DylanCaen/Linefollower/readme.md

# LineFollower
<br />
<br />
[line follower](https://user-images.githubusercontent.com/114856811/209238301-1bc431f7-9a41-4f4b-89cb-30bd2896c6eb.jpg)
<br />
<br />
  
## specifications
<br />
microcontroller: Atmega32U4 (Arduino pro micro)
<br />
motors: Micro metal gear motor 50:1 6V 650rpm 
<br />
h-bridge: DRV8833
<br />
sensors: QTR-8A
<br />
batteries: 2x li-ion 3,7V, 2600mAh
<br />
wireless communication: HC-05 (bluethooth)
<br />
distance sensor - motors: 12cm
<br />
weight: 300gr
<br />
speed: 0,565m/s
<br />
