DylanCaen/Linefollower/code/proof of concepts/readme.md

# Proof of Concepts

Een proof of concept is een combinatie van minimale hard- en software om eenvoudig aan te tonen dat iets werkt.  
Proof of concepts kunnen enerzijds als eerste poging dienen om een bepaald onderdeel van het project werkend te krijgen. Anderzijds kunnen ze tijdens het debuggen van het finale project dienen als test om eventuele hardware problemen te elimineren bij onduidelijke problemen.
<br />  
<br />
Een proof of concept bestaat uit
* een elektronisch schema (indien van toepassing)
* minimale code om de voorop gestelde zaken te demonstreren
* minimale uitleg / aandachtspunten
<br />
De elektronische schakelingen van de proof of concepts komen bij voorkeur overeen met deze van de uiteindelijke linefollower, zodat de code zonder aanpassingen op het finale project kan draaien.
