DylanCaen/Linefollower/bill of materials/readme.md

## bill of materials
<br />

|volgnummer|naam|omschrijving|nieuw/recup|kostprijs/stuk (€)|aantal|subtotaal|
|---|----|---|---|---|---|---|
| 1|Li-ion batterij|3,7V; 2600mAh|nieuw|2,95|2|5,90|
| 2|Li-ion batterij lader||nieuw|7,99|1|7,99| 
| 3|Li-ion batterij houder||nieuw|1,39|1|1,39|
| 4|Micro metal Gear Motor|50:1; 6V; 650rpm|nieuw|6,95|2|13,90|
| 5|DRV8833|H-brug (2,7V-10,8V)|nieuw|5,75|1|5,75|
| 6|QTR-8A|Sensor (3,3V-5V)|nieuw|12,28|1|12,28|
| 7|HC-05|Bleuthooth-module|recup| | | |
| 8|Arduino Pro Micro|Atmega 32U|recup| | | |
| 9|Printplaat|grondplaat|recup| | | |
| 10|Drukknop|Start/Stop drukknop|recup| | | |
| 11|Schakelaar|Power On/Off|recup| | | |
| 12|Led|On/Off Led|recup| | | |
| 13|Wielen||nieuw|4,88|1|4,88|
| 14|Micro metal Gear Motor bracket|Bevestiging voor de motoren|nieuw|3,64|1|3,64|
