DylanCaen/Linefollower/code/proof of concepts/sensor/Schema QTR-8A sensor.pdf

A | A

1

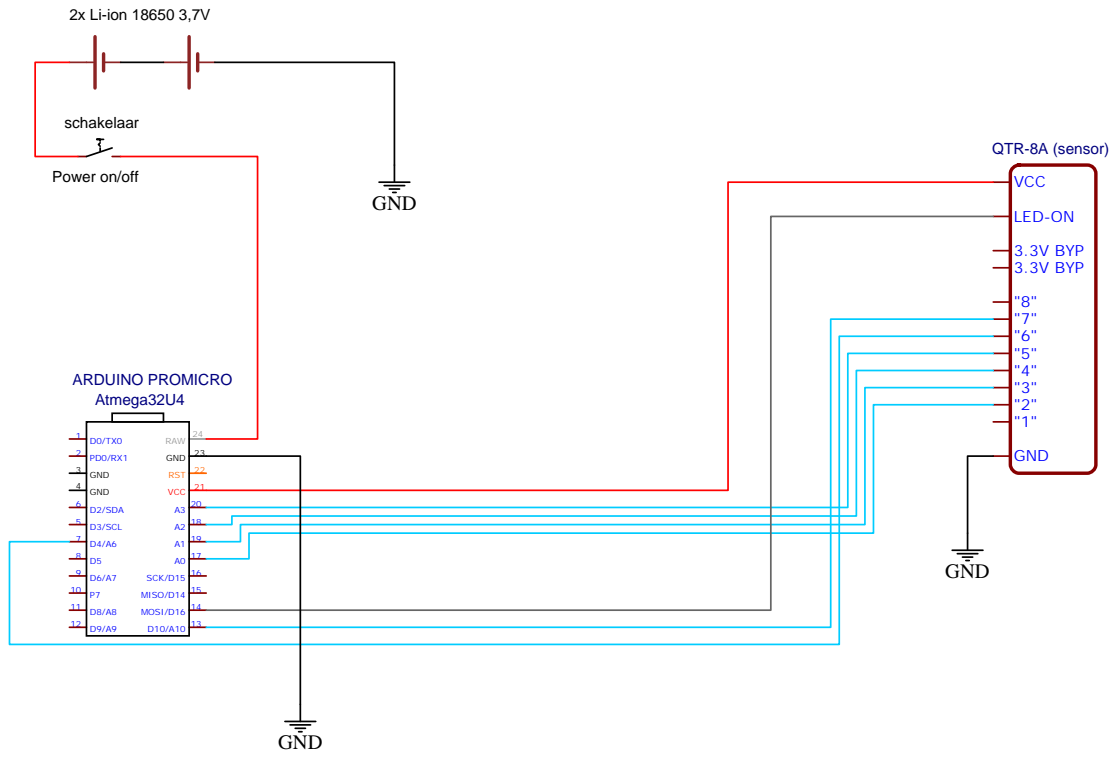
[picture p7: page 1]

TITLE: Elektrisch schema QTR-8A sensor
