DylanCaen/Linefollower/code/proof of concepts/interrupt/Schema drukknop (interrupt).pdf

A | A

1

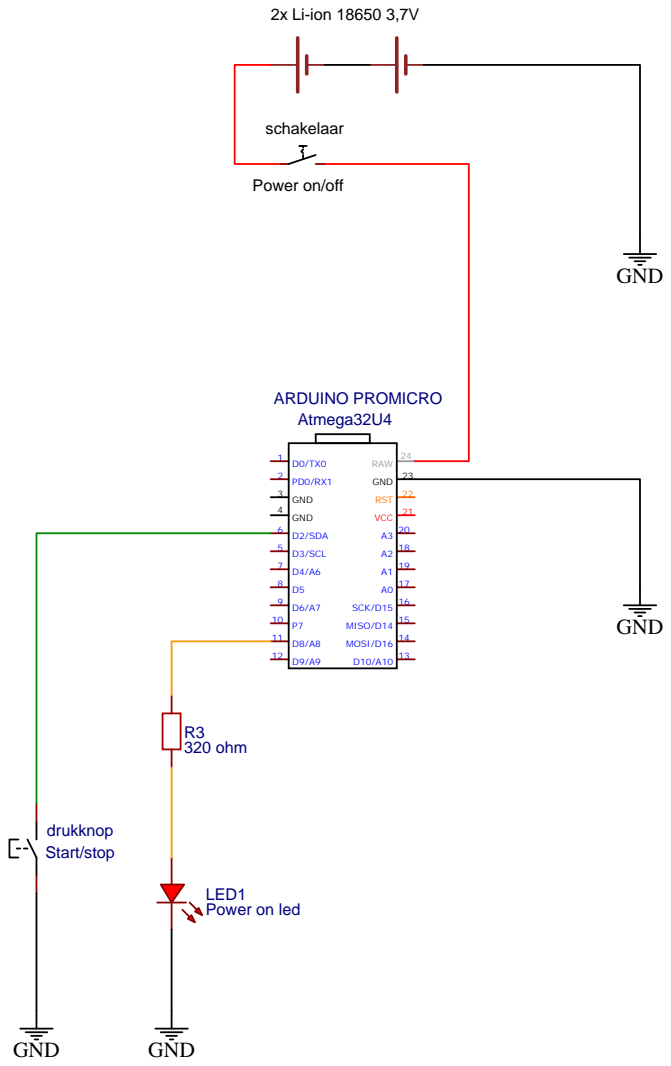
[picture p8: page 1]

TITLE: Elektrisch schema Start/Stop drukknopmet Power on led
