DylanCaen/Linefollower/code/proof of concepts/hbridge/Schema Hbrige + motoren.pdf

A | A

1

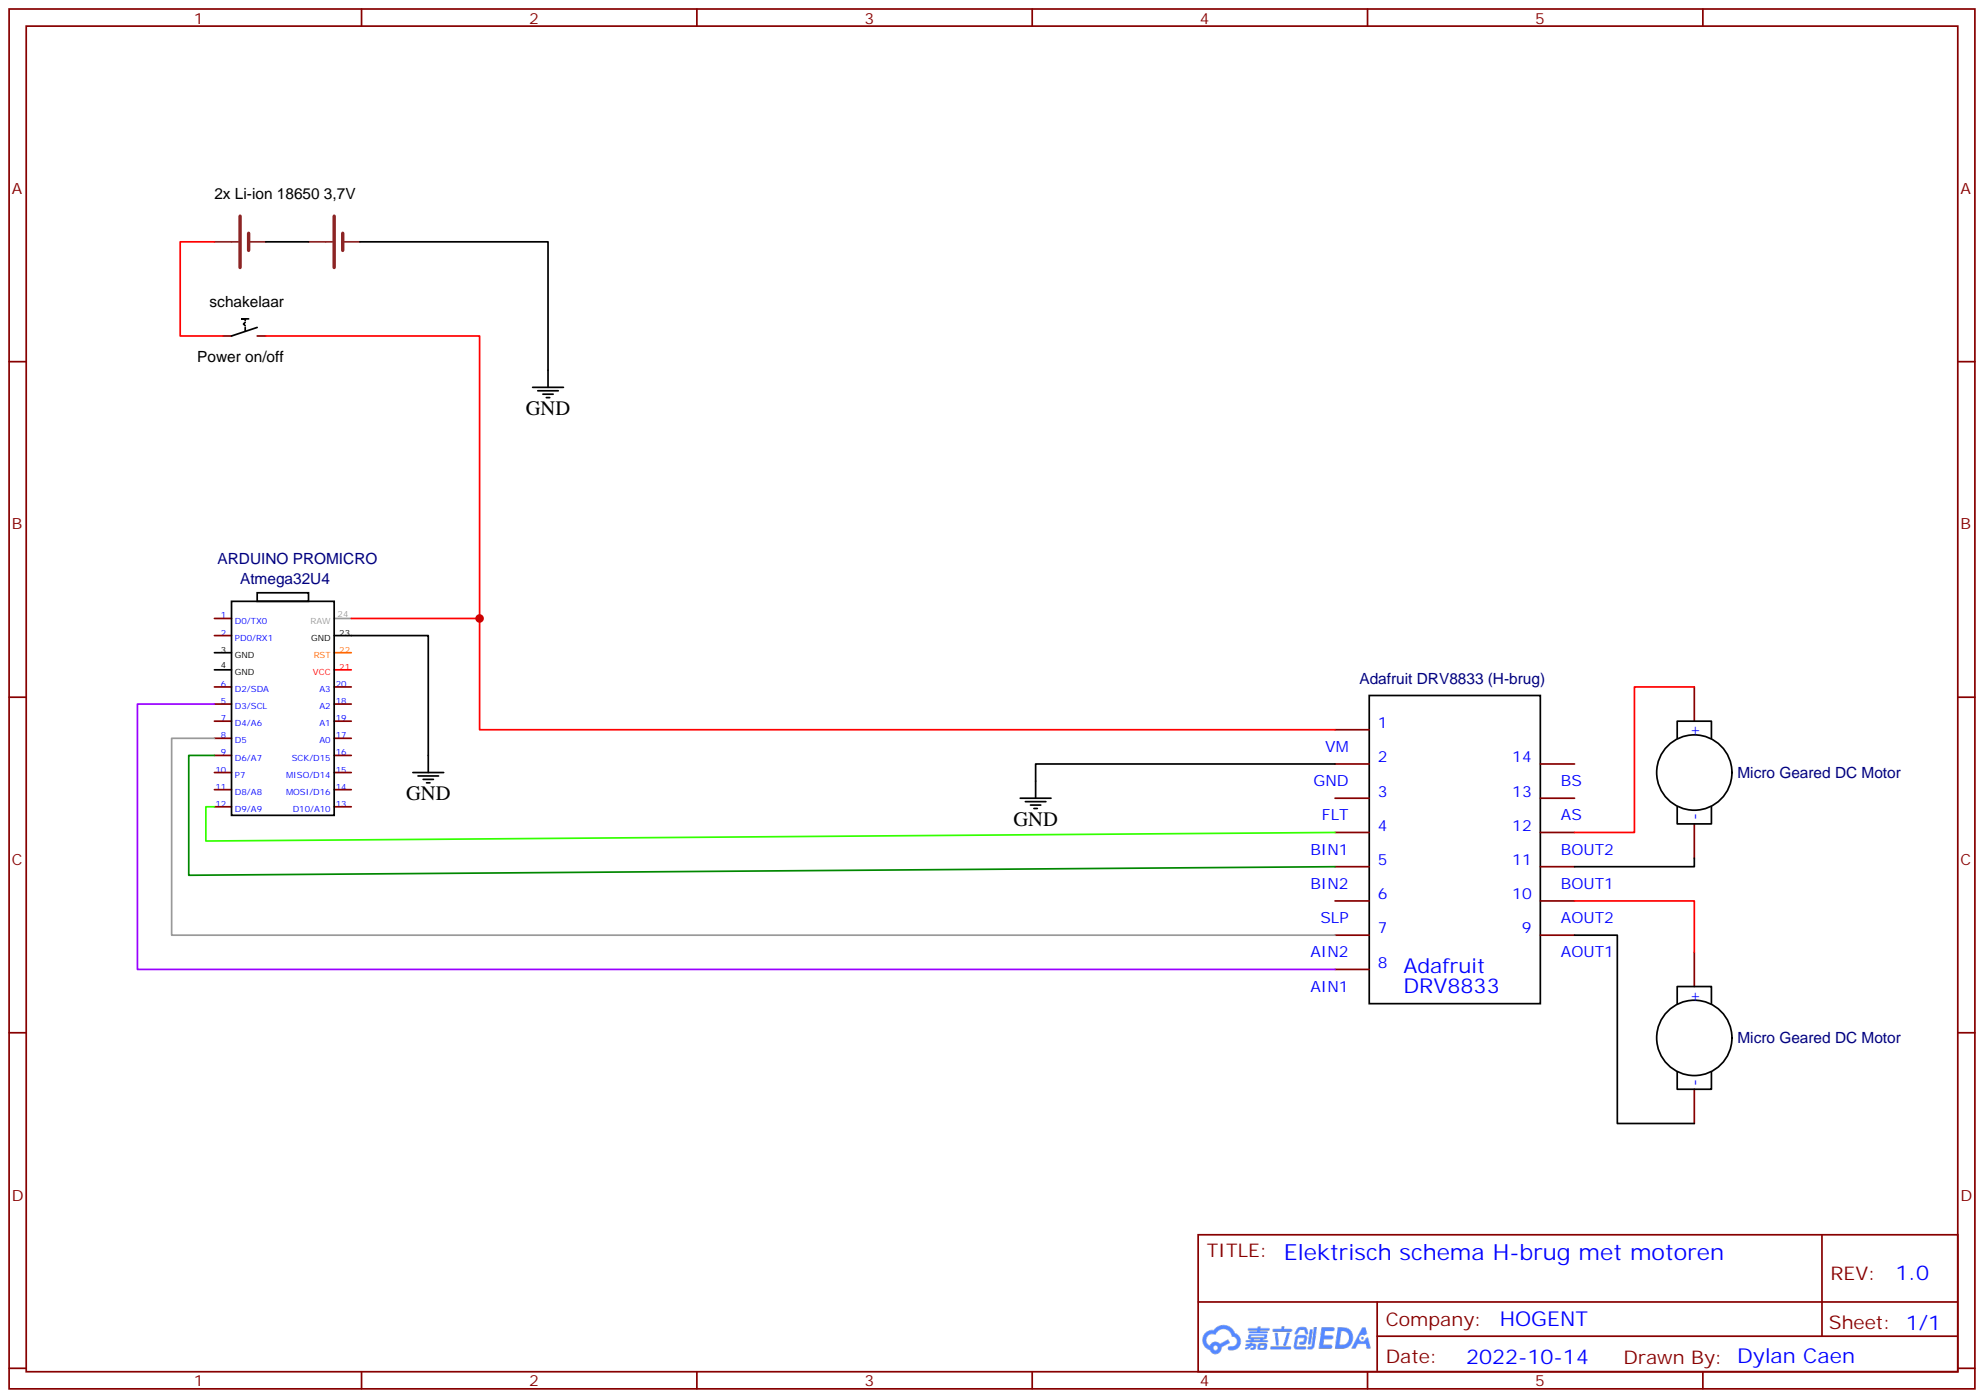
[picture p9: page 1]

Micro Geared DC Motor

TITLE: Elektrisch schema H-brug met motoren
