DylanCaen/Linefollower/technische tekeningen/elektronisch/Elektronisch schema plan b.pdf

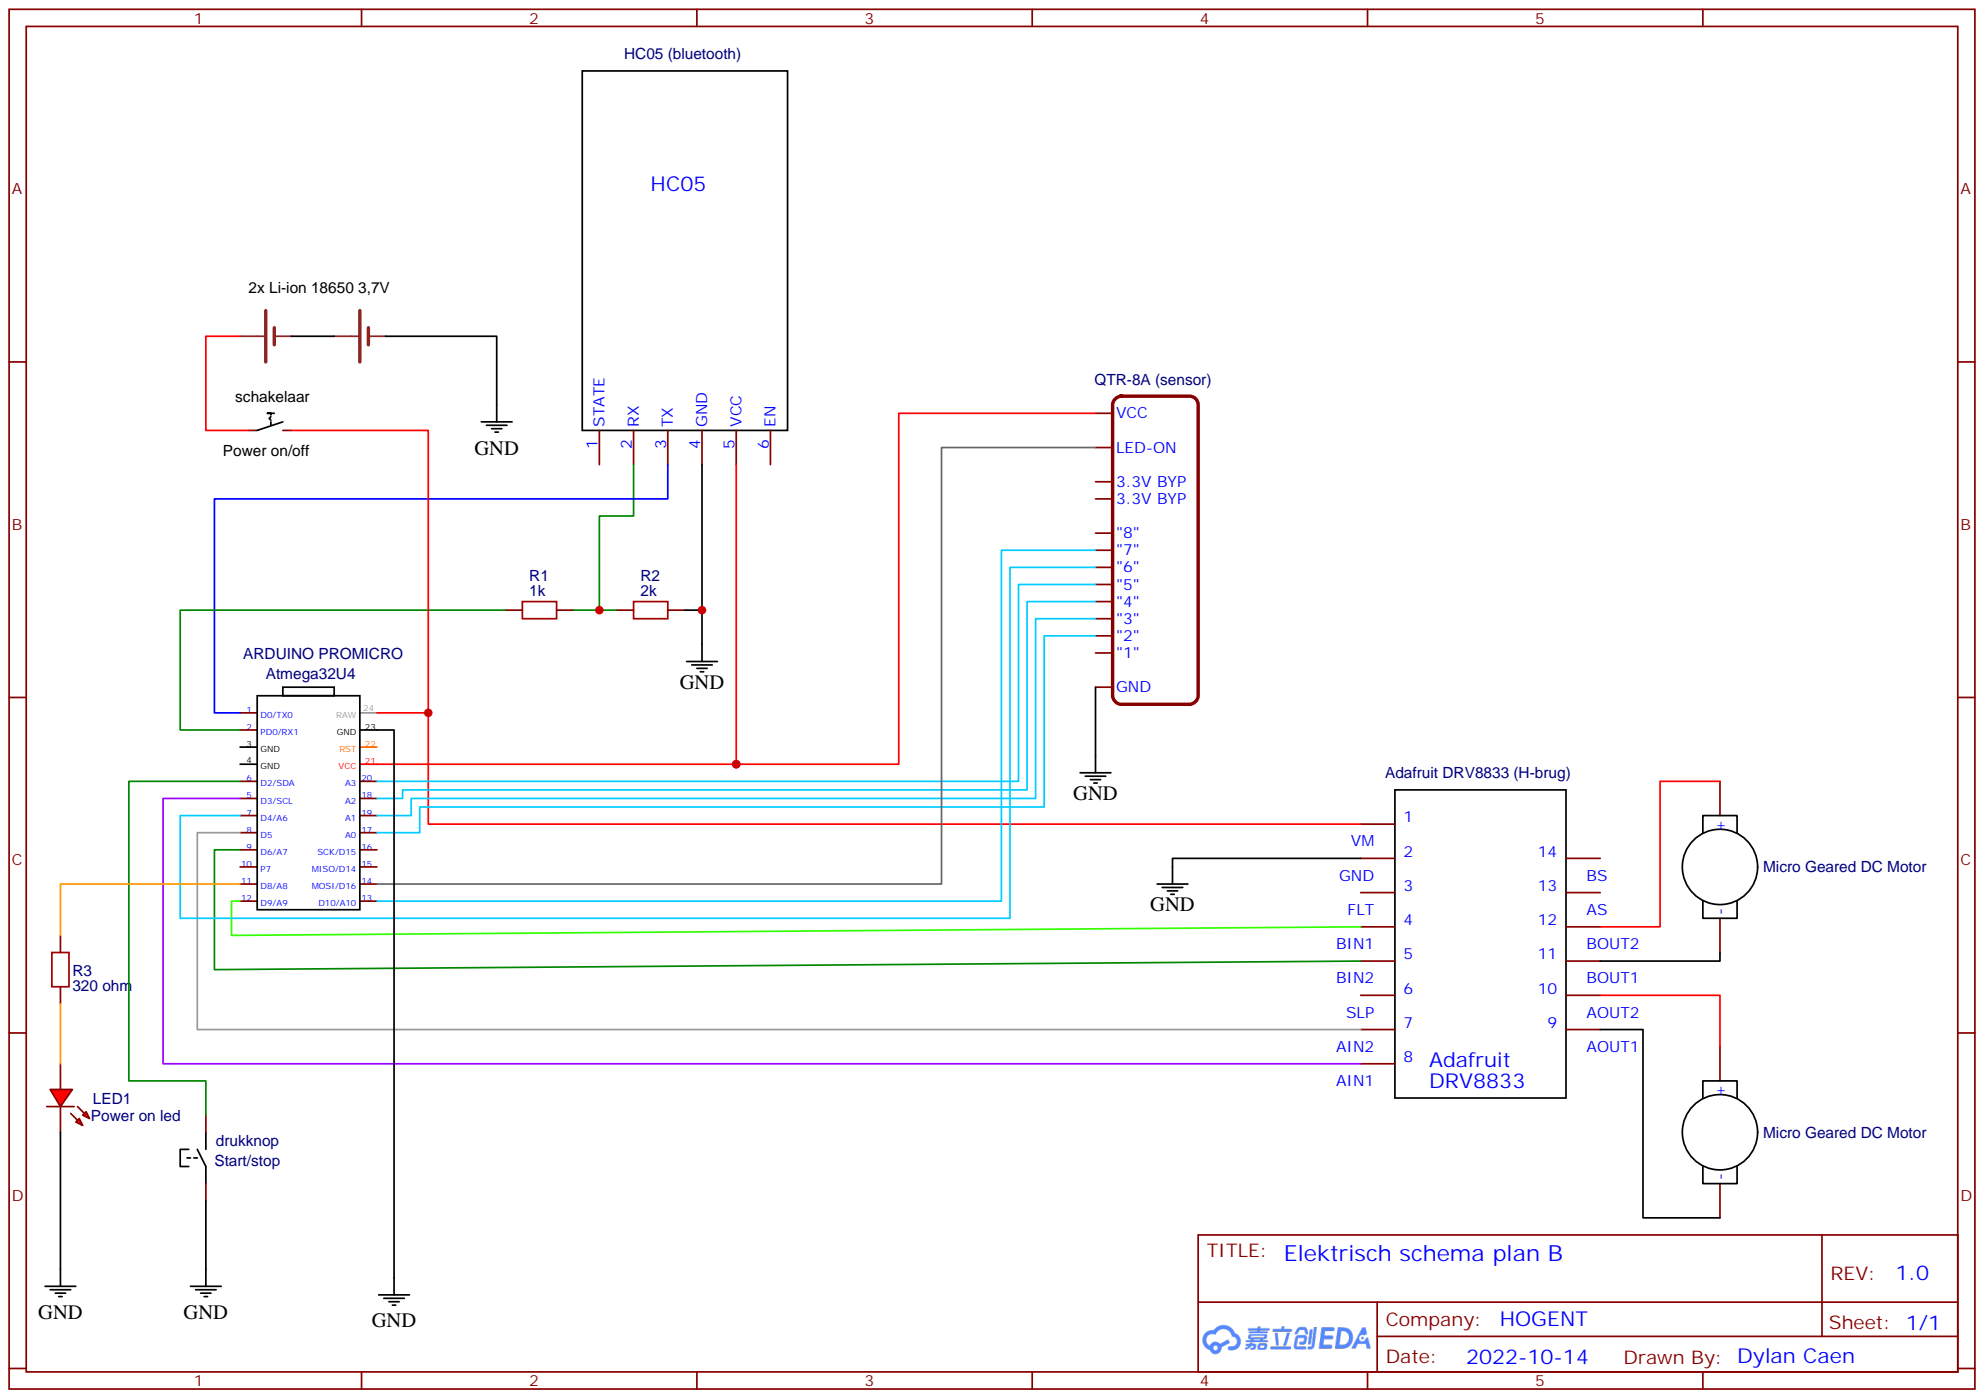
[picture p10: page 1]

Micro Geared DC Motor

TITLE: Elektrisch schema plan B
