DylanCaen/Linefollower/code/proof of concepts/wireless communication/Schema HC05-module.pdf

A | A

1

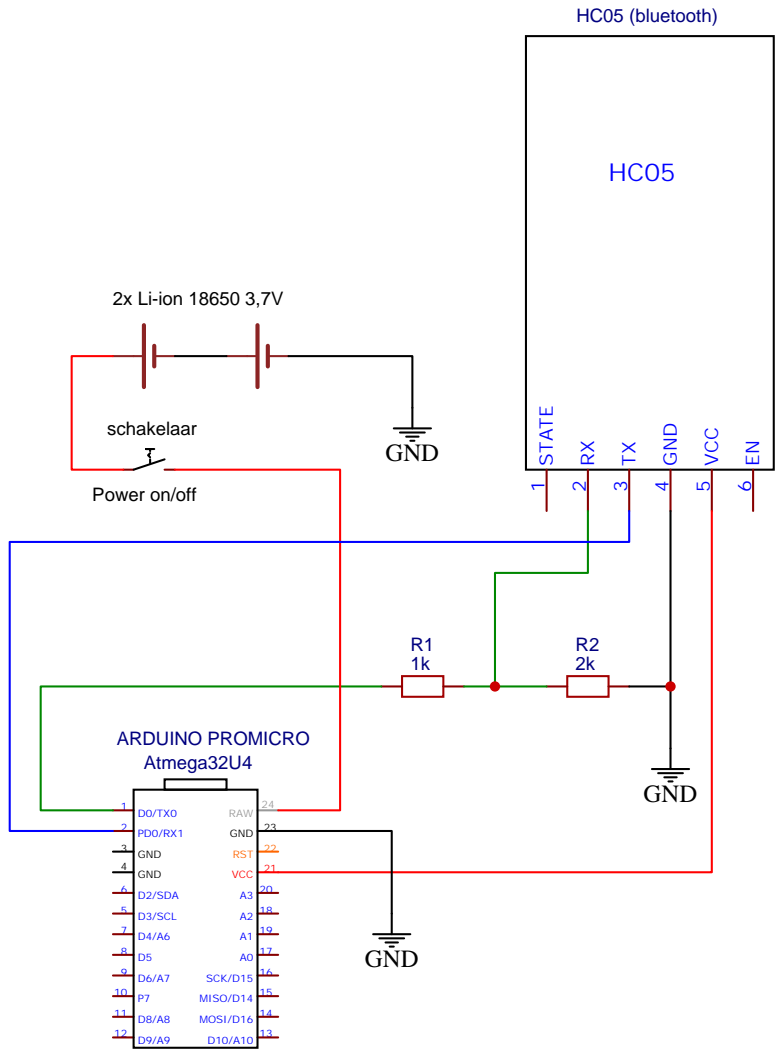
[picture p11: page 1]

TITLE: Elektrisch schema HC-05
